supermileage/CAN-Accessories-2026/New CAN Accessories board/3D models/AT06-2S-SR01BLK.STEP

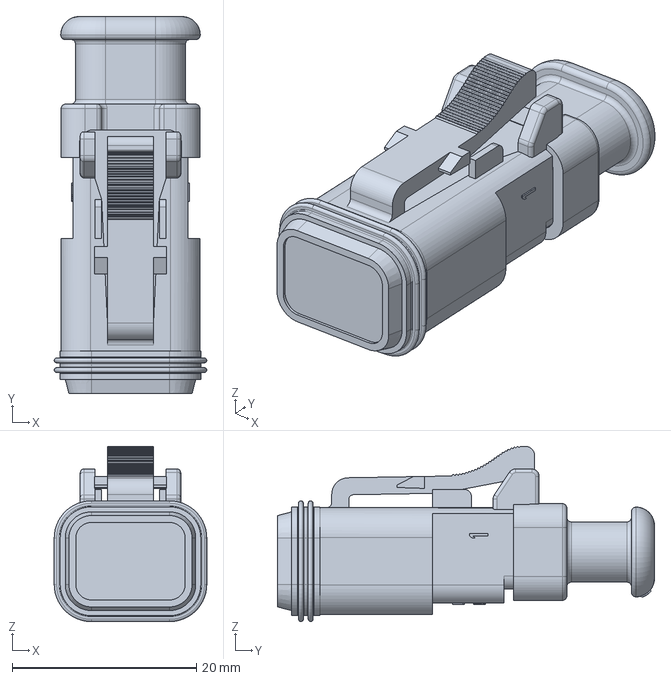
[picture p1: CAD file, 2025-10-22]
New CAN Accessories board/3D models/AT06-2S-SR01BLK.STEP
16.6 x 40.9 x 19.0 mm
