supermileage/CAN-Accessories-2026/New CAN Accessories board/topstencil.SLDPRT

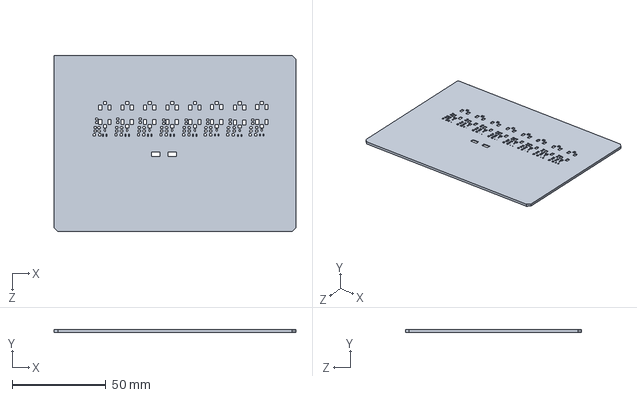
[picture p2: CAD file, 2025-10-27]
New CAN Accessories board/topstencil.SLDPRT
129.0 x 1.50 x 94.0 mm
