supermileage/CAN-Accessories-2026/PCB enclosure/box-can-accessories.SLDPRT

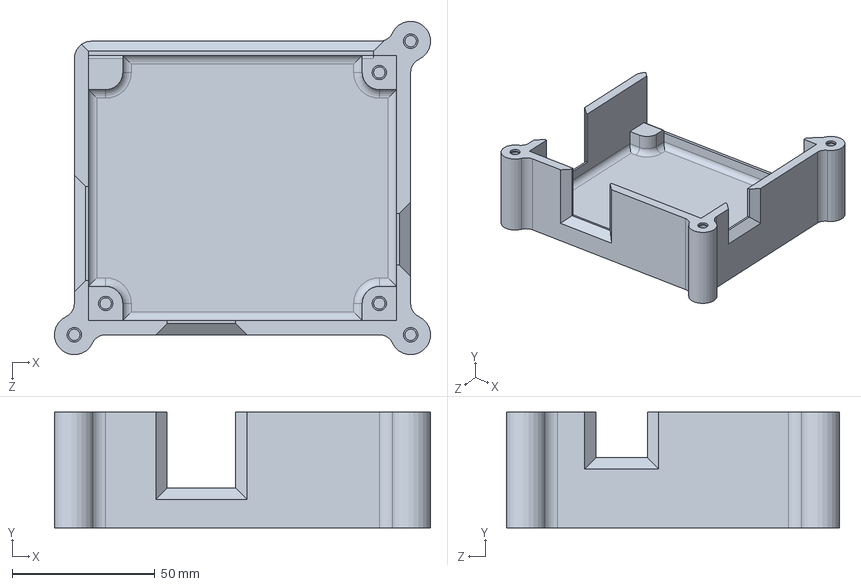
[picture p3: CAD file, 2025-10-27]
PCB enclosure/box-can-accessories.SLDPRT
131.9 x 40.6 x 116.9 mm
