supermileage/CAN-Accessories-2026/New CAN Accessories board/3D models/HHXC350ARA271MJA0G.stp

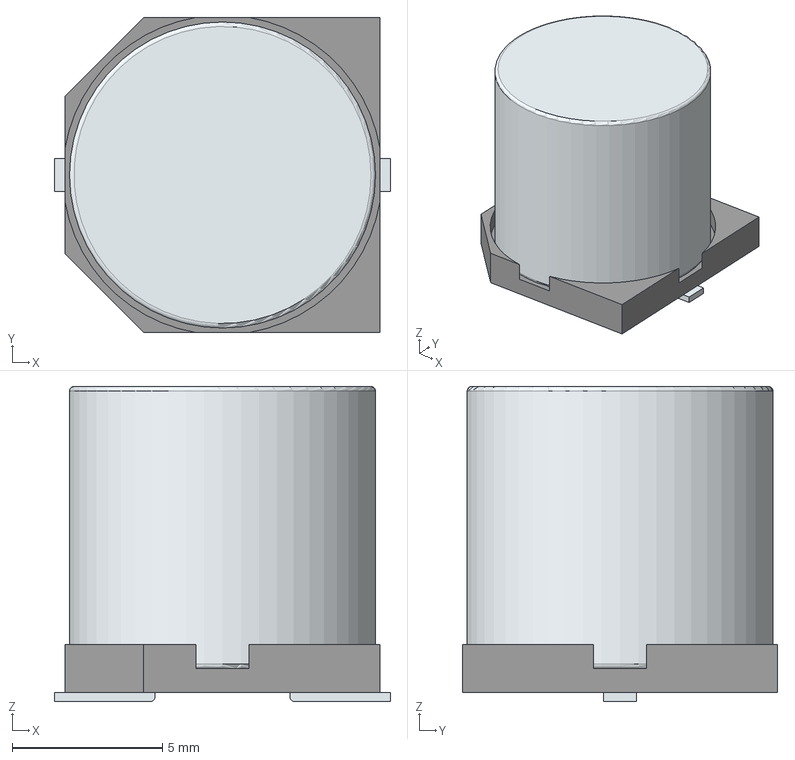
[picture p4: CAD file, 2025-10-19]
New CAN Accessories board/3D models/HHXC350ARA271MJA0G.stp
11.2 x 10.5 x 10.5 mm
Base
Pin1Fillet
Pin2Fillet
