supermileage/CAN-Accessories-2026/New CAN Accessories board/New CAN Accessories board-PasteBottom.dxf

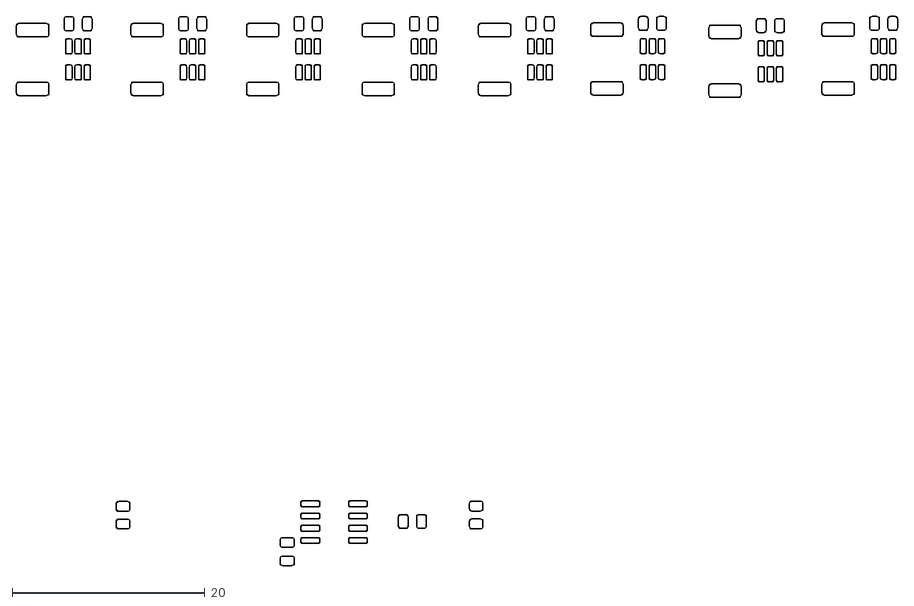
[picture p5: CAD file, 2025-10-27]
New CAN Accessories board/New CAN Accessories board-PasteBottom.dxf
91.5 x 57.0
