supermileage/CAN-Accessories-2026/New CAN Accessories board/New CAN Accessories board-PasteTop.dxf

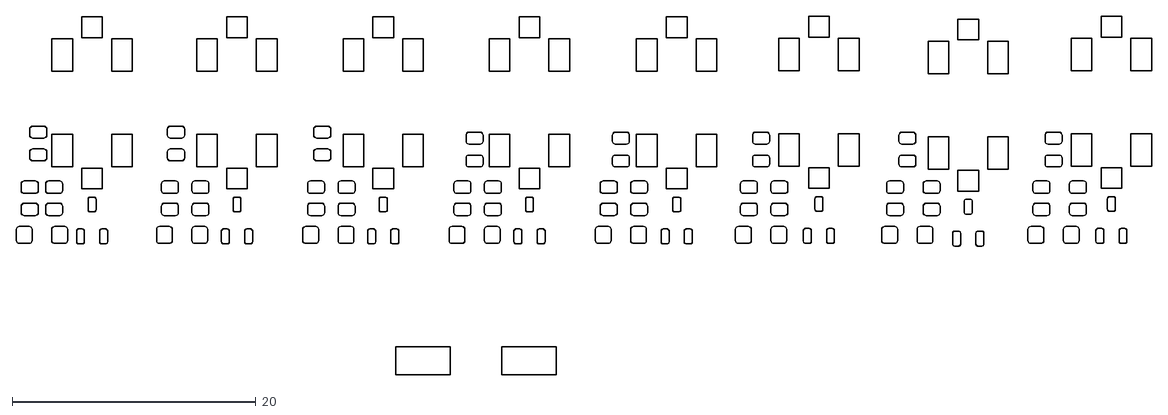
[picture p6: CAD file, 2025-10-27]
New CAN Accessories board/New CAN Accessories board-PasteTop.dxf
93.1 x 29.4
