supermileage/CAN-Accessories-2026/New CAN Accessories board/New CAN Accessories board-EdgeCuts.dxf

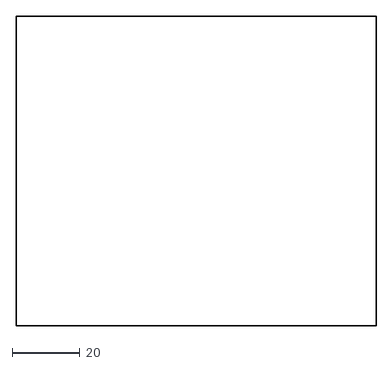
[picture p7: CAD file, 2025-10-27]
New CAN Accessories board/New CAN Accessories board-EdgeCuts.dxf
106.0 x 91.0
