supermileage/CAN-Accessories-2026/New CAN Accessories board/3D models/3586KTR.stp

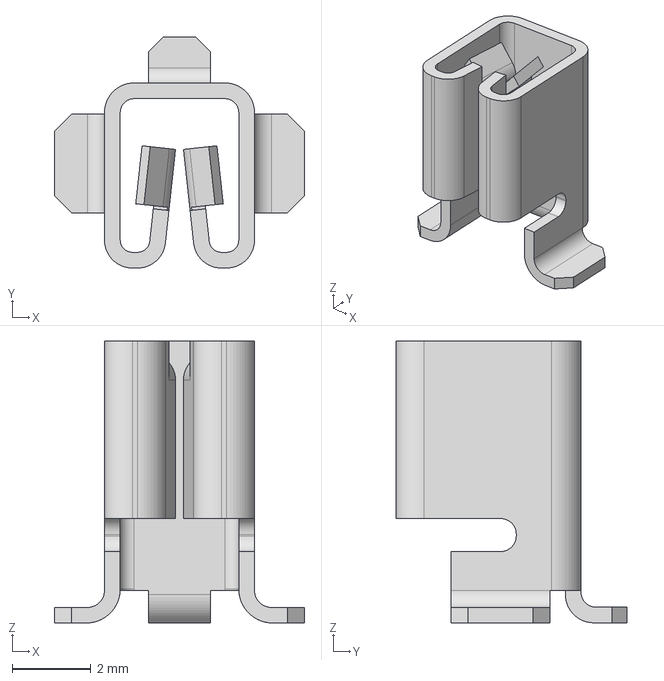
[picture p8: CAD file, 2025-10-18]
New CAN Accessories board/3D models/3586KTR.stp
6.35 x 5.87 x 7.16 mm
