supermileage/CAN-Accessories-2026/New CAN Accessories board/3D models/ATF13-2P-BM03.STEP

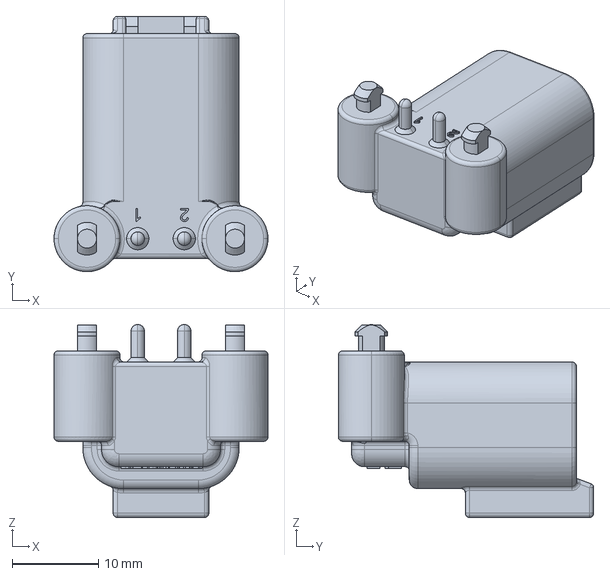
[picture p9: CAD file, 2025-10-18]
New CAN Accessories board/3D models/ATF13-2P-BM03.STEP
24.8 x 29.6 x 22.4 mm
