supermileage/CAN-Accessories-2026/New CAN Accessories board/3D models/PPPC151LFBN-RC.STEP

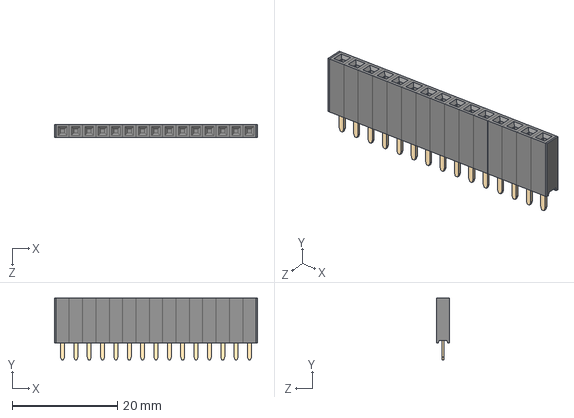
[picture p10: CAD file, 2025-10-18]
New CAN Accessories board/3D models/PPPC151LFBN-RC.STEP
38.6 x 11.7 x 2.54 mm
PPPC021LFBN-RC_C15
Pin - Gold x 15
