supermileage/CAN-Accessories-2026/New CAN Accessories board/3D models/039301040.stp

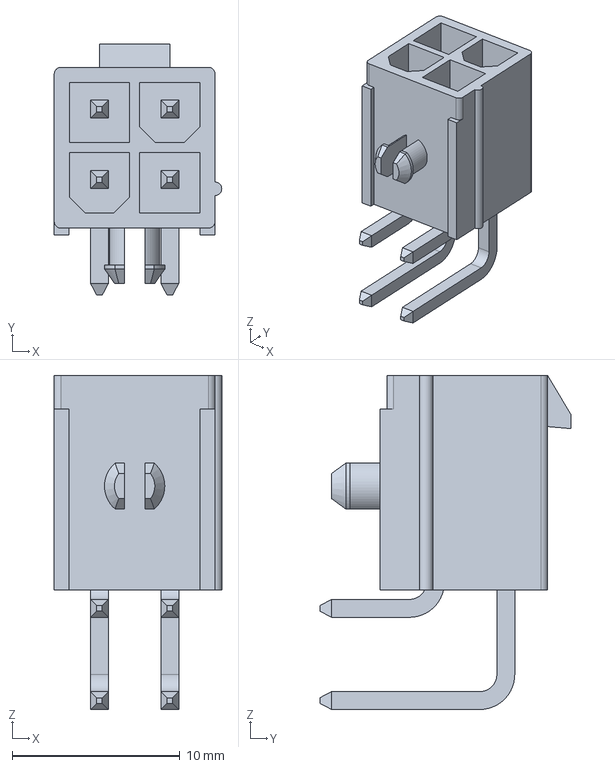
[picture p11: CAD file, 2025-10-18]
New CAN Accessories board/3D models/039301040.stp
10.0 x 15.0 x 19.9 mm
