supermileage/CAN-Accessories-2026/New CAN Accessories board/3D models/JS202011CQN.STEP

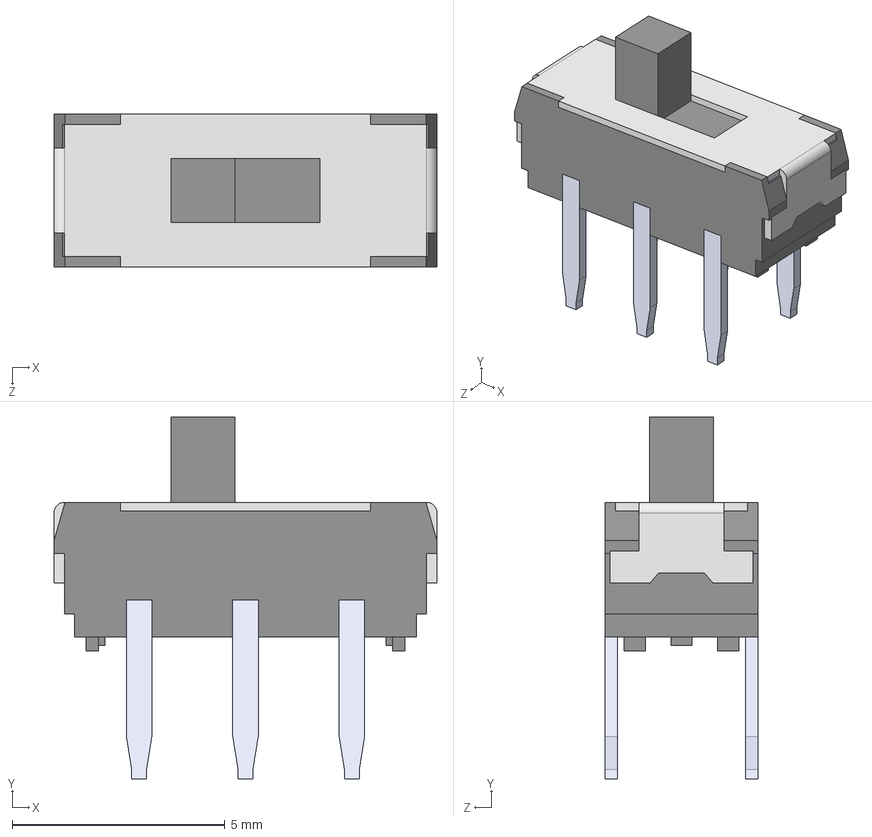
[picture p12: CAD file, 2025-10-18]
New CAN Accessories board/3D models/JS202011CQN.STEP
9.00 x 8.50 x 3.60 mm
