supermileage/CAN-Accessories-2026/New CAN Accessories board/3D models/039301060.stp

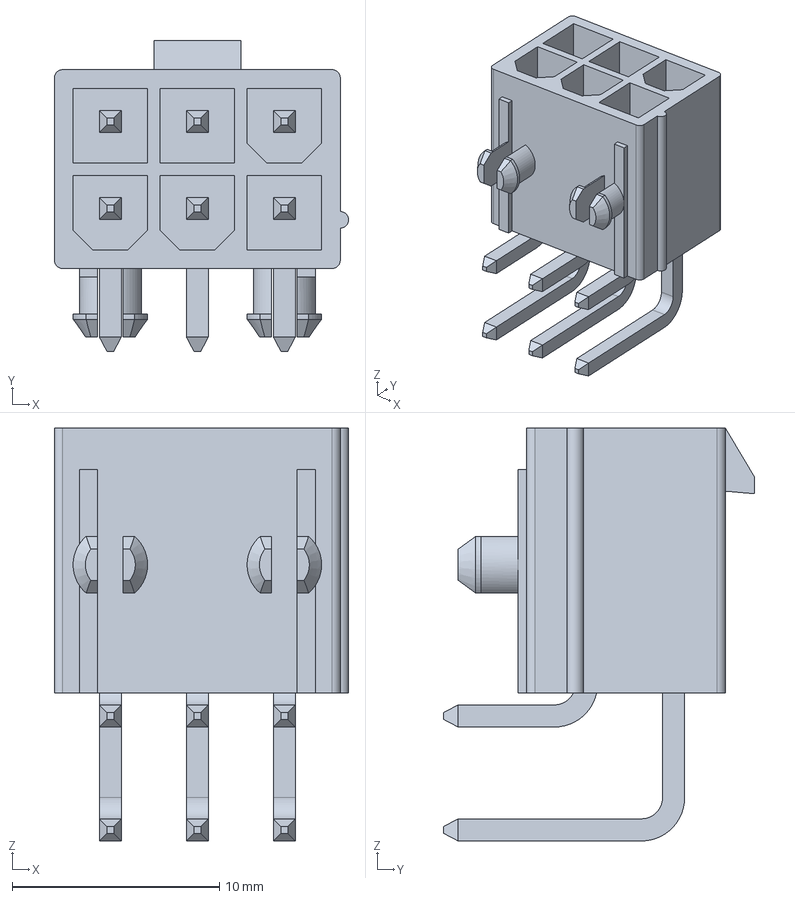
[picture p13: CAD file, 2025-10-18]
New CAN Accessories board/3D models/039301060.stp
14.2 x 15.0 x 19.9 mm
