supermileage/CAN-Accessories-2026/New CAN Accessories board/New CAN Accessories board.kicad_pcb

## KiCad design New CAN Accessories board/New CAN Accessories board.kicad_pcb (2025-10-27)

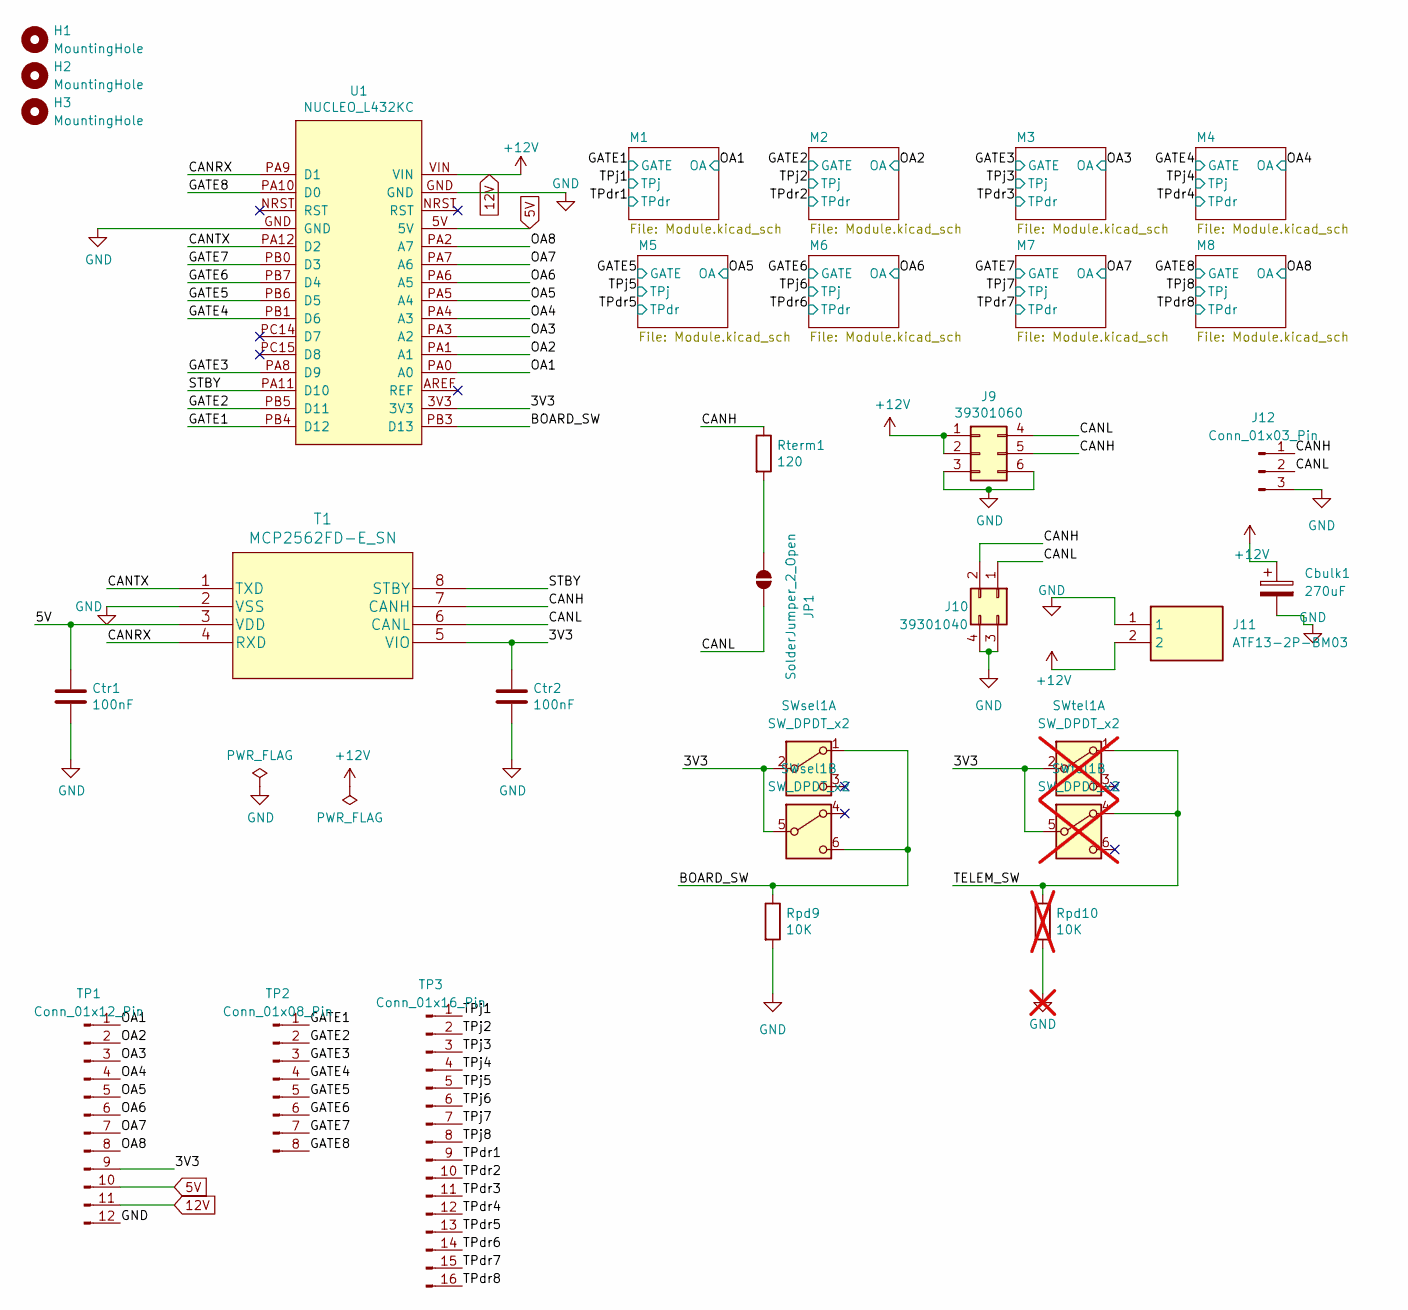
[picture p14: schematic New CAN Accessories board.kicad_sch]

Parts:
Cbulk1: 270uF; CAPAE1030X1050M
Ctr1, Ctr2: 100nF; C_0805_2012Metric
H1, H2, H3: MountingHole; MountingHole_3.2mm_M3_ISO14580
J9: 39301060; Molex_Mini-Fit_Jr_5569-06A2_2x03_P4.20mm_Horizontal
J10: 39301040; Molex_Mini-Fit_Jr_5569-04A2_2x02_P4.20mm_Horizontal
J11: ATF13-2P-BM03; ATF132PBM03; Mouser Part Number 654-ATF13-2P-BM03
J12: Conn_01x03_Pin; PinHeader_1x03_P2.54mm_Vertical
JP1: SolderJumper_2_Open; SolderJumper-2_P1.3mm_Open_Pad1.0x1.5mm
Rpd9: 10K; R_0805_2012Metric
Rpd10: 10K; R_0805_2012Metric; not fitted
Rterm1: 120; R_0805_2012Metric
SWsel1: SW_DPDT_x2; SWITCH_011CQN
SWtel1: SW_DPDT_x2; SWITCH_011CQN; not fitted
T1: MCP2562FD-E_SN; SOIC-8_3.9x4.9mm_P1.27mm
TP1: Conn_01x12_Pin; PinHeader_1x12_P2.54mm_Vertical
TP2: Conn_01x08_Pin; PinHeader_1x08_P2.54mm_Vertical
TP3: Conn_01x16_Pin; PinHeader_1x16_P2.54mm_Vertical
U1: NUCLEO_L432KC; MODULE_NUCLEO-L432KC

Connections:
5V: Ctr1.1, T1.3 (VDD), TP1.10, U1.5V; also elsewhere on the board
12V: Cbulk1.1, J9.1, J9.2, J11.2, TP1.11, U1.VIN; also elsewhere on the board
/3V3: Ctr2.1, SWsel1.2 (B), SWsel1.5 (B), SWtel1.2 (B), SWtel1.5 (B), T1.5 (VIO), TP1.9, U1.3V3
/BOARD_SW: Rpd9.1, SWsel1.1 (A), SWsel1.6 (C), U1.PB3 (D13)
/CANH: J9.5, J10.2, J12.1, Rterm1.1, T1.7 (CANH)
/CANL: J9.4, J10.1, J12.2, JP1.2 (B), T1.6 (CANL)
/CANRX: T1.4 (RXD), U1.PA9 (D1)
/CANTX: T1.1 (TXD), U1.PA12 (D2)
/GATE1: TP2.1, U1.PB4 (D12); also elsewhere on the board
/GATE2: TP2.2, U1.PB5 (D11); also elsewhere on the board
/GATE3: TP2.3, U1.PA8 (D9); also elsewhere on the board
/GATE4: TP2.4, U1.PB1 (D6); also elsewhere on the board
/GATE5: TP2.5, U1.PB6 (D5); also elsewhere on the board
/GATE6: TP2.6, U1.PB7 (D4); also elsewhere on the board
/GATE7: TP2.7, U1.PB0 (D3); also elsewhere on the board
/GATE8: TP2.8, U1.PA10 (D0); also elsewhere on the board
/OA1: TP1.1, U1.PA0 (A0); also elsewhere on the board
/OA2: TP1.2, U1.PA1 (A1); also elsewhere on the board
/OA3: TP1.3, U1.PA3 (A2); also elsewhere on the board
/OA4: TP1.4, U1.PA4 (A3); also elsewhere on the board
/OA5: TP1.5, U1.PA5 (A4); also elsewhere on the board
/OA6: TP1.6, U1.PA6 (A5); also elsewhere on the board
/OA7: TP1.7, U1.PA7 (A6); also elsewhere on the board
/OA8: TP1.8, U1.PA2 (A7); also elsewhere on the board
/STBY: T1.8 (STBY), U1.PA11 (D10)
/TPdr1: TP3.9; also elsewhere on the board
/TPdr2: TP3.10; also elsewhere on the board
/TPdr3: TP3.11; also elsewhere on the board
/TPdr4: TP3.12; also elsewhere on the board
/TPdr5: TP3.13; also elsewhere on the board
/TPdr6: TP3.14; also elsewhere on the board
/TPdr7: TP3.15; also elsewhere on the board
/TPdr8: TP3.16; also elsewhere on the board
/TPj1: TP3.1; also elsewhere on the board
/TPj2: TP3.2; also elsewhere on the board
/TPj3: TP3.3; also elsewhere on the board
/TPj4: TP3.4; also elsewhere on the board
/TPj5: TP3.5; also elsewhere on the board
/TPj6: TP3.6; also elsewhere on the board
/TPj7: TP3.7; also elsewhere on the board
/TPj8: TP3.8; also elsewhere on the board
GND: Cbulk1.2, Ctr1.2, Ctr2.2, J9.3, J9.6, J10.3, J10.4, J11.1, J12.3, Rpd9.2, Rpd10.2, T1.2 (VSS), TP1.12, U1.GND; also elsewhere on the board
unnamed: JP1.1 (A), Rterm1.2
unnamed: Rpd10.1, SWtel1.1 (A), SWtel1.4 (A)

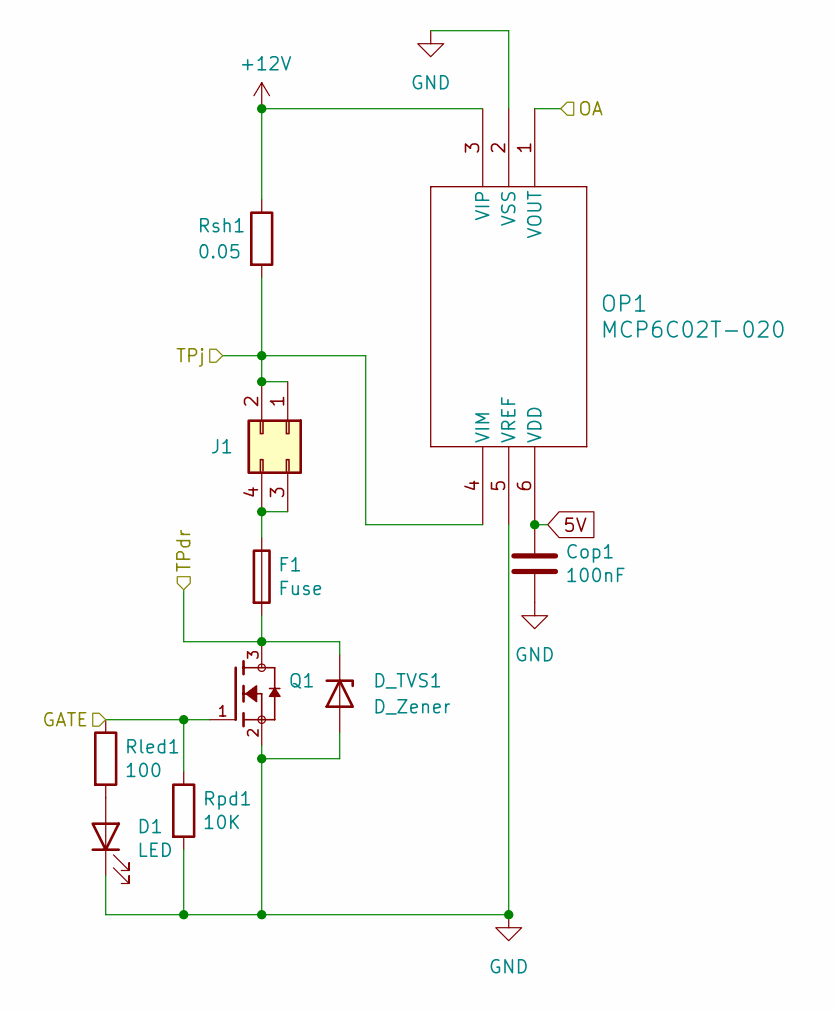
[picture p15: schematic Module.kicad_sch]

Parts:
Cop1: 100nF; C_0805_2012Metric
D1: LED; LED_0805_2012Metric
D_TVS1: D_Zener; D_SMF
F1: Fuse; 3586KTR
J1: 39301040; Molex_Mini-Fit_Jr_5569-04A2_2x02_P4.20mm_Horizontal
OP1: MCP6C02T-020; SOT-23-6_Handsoldering
Q1: IRLML6344TRPBF; TSOT-23; PARTREV December 19, 2014
Rled1: 100; R_0805_2012Metric
Rpd1: 10K; R_0805_2012Metric
Rsh1: 0.05; R_2512_6332Metric_Pad1.40x3.35mm_HandSolder

Connections:
5V: Cop1.1, OP1.6 (VDD); also elsewhere on the board
12V: OP1.3 (VIP), Rsh1.1; also elsewhere on the board
/GATE1: Q1.1, Rled1.1, Rpd1.1; also elsewhere on the board
/OA1: OP1.1 (VOUT); also elsewhere on the board
/TPdr1: D_TVS1.1 (K), F1.2, Q1.3; also elsewhere on the board
/TPj1: J1.1, J1.2, OP1.4 (VIM), Rsh1.2; also elsewhere on the board
GND: Cop1.2, D1.1 (K), D_TVS1.2 (A), OP1.2 (VSS), OP1.5 (VREF), Q1.2, Rpd1.2; also elsewhere on the board
unnamed: D1.2 (A), Rled1.2
unnamed: F1.1, J1.3, J1.4

Parts of its further copies:
Cop2, Cop3, Cop4, Cop5, Cop6, Cop7, Cop8: 100nF; C_0805_2012Metric
D2, D3, D4, D5, D6, D7, D8: LED; LED_0805_2012Metric
D_TVS2, D_TVS3, D_TVS4, D_TVS5, D_TVS6, D_TVS7, D_TVS8: D_Zener; D_SMF
F2, F3, F4, F5, F6, F7, F8: Fuse; 3586KTR
J2, J3, J4, J5, J6, J7, J8: 39301040; Molex_Mini-Fit_Jr_5569-04A2_2x02_P4.20mm_Horizontal
OP2, OP3, OP4, OP5, OP6, OP7, OP8: MCP6C02T-020; SOT-23-6_Handsoldering
Q2, Q3, Q4, Q5, Q6, Q7, Q8: IRLML6344TRPBF; TSOT-23; PARTREV December 19, 2014
Rled2, Rled3, Rled4, Rled5, Rled6, Rled7, Rled8: 100; R_0805_2012Metric
Rpd2, Rpd3, Rpd4, Rpd5, Rpd6, Rpd7, Rpd8: 10K; R_0805_2012Metric
Rsh2, Rsh3, Rsh4, Rsh5, Rsh6, Rsh7, Rsh8: 0.05; R_2512_6332Metric_Pad1.40x3.35mm_HandSolder

Connections of its further copies:
5V: Cop2.1, Cop3.1, Cop4.1, Cop5.1, Cop6.1, Cop7.1, Cop8.1, OP2.6 (VDD), OP3.6 (VDD), OP4.6 (VDD), OP5.6 (VDD), OP6.6 (VDD), OP7.6 (VDD), OP8.6 (VDD); also elsewhere on the board
12V: OP2.3 (VIP), OP3.3 (VIP), OP4.3 (VIP), OP5.3 (VIP), OP6.3 (VIP), OP7.3 (VIP), OP8.3 (VIP), Rsh2.1, Rsh3.1, Rsh4.1, Rsh5.1, Rsh6.1, Rsh7.1, Rsh8.1; also elsewhere on the board
/GATE2: Q2.1, Rled2.1, Rpd2.1; also elsewhere on the board
/GATE3: Q3.1, Rled3.1, Rpd3.1; also elsewhere on the board
/GATE4: Q4.1, Rled4.1, Rpd4.1; also elsewhere on the board
/GATE5: Q5.1, Rled5.1, Rpd5.1; also elsewhere on the board
/GATE6: Q6.1, Rled6.1, Rpd6.1; also elsewhere on the board
/GATE7: Q7.1, Rled7.1, Rpd7.1; also elsewhere on the board
/GATE8: Q8.1, Rled8.1, Rpd8.1; also elsewhere on the board
/OA2: OP2.1 (VOUT); also elsewhere on the board
/OA3: OP3.1 (VOUT); also elsewhere on the board
/OA4: OP4.1 (VOUT); also elsewhere on the board
/OA5: OP5.1 (VOUT); also elsewhere on the board
/OA6: OP6.1 (VOUT); also elsewhere on the board
/OA7: OP7.1 (VOUT); also elsewhere on the board
/OA8: OP8.1 (VOUT); also elsewhere on the board
/TPdr2: D_TVS2.1 (K), F2.2, Q2.3; also elsewhere on the board
/TPdr3: D_TVS3.1 (K), F3.2, Q3.3; also elsewhere on the board
/TPdr4: D_TVS4.1 (K), F4.2, Q4.3; also elsewhere on the board
/TPdr5: D_TVS5.1 (K), F5.2, Q5.3; also elsewhere on the board
/TPdr6: D_TVS6.1 (K), F6.2, Q6.3; also elsewhere on the board
/TPdr7: D_TVS7.1 (K), F7.2, Q7.3; also elsewhere on the board
/TPdr8: D_TVS8.1 (K), F8.2, Q8.3; also elsewhere on the board
/TPj2: J2.1, J2.2, OP2.4 (VIM), Rsh2.2; also elsewhere on the board
/TPj3: J3.1, J3.2, OP3.4 (VIM), Rsh3.2; also elsewhere on the board
/TPj4: J4.1, J4.2, OP4.4 (VIM), Rsh4.2; also elsewhere on the board
/TPj5: J5.1, J5.2, OP5.4 (VIM), Rsh5.2; also elsewhere on the board
/TPj6: J6.1, J6.2, OP6.4 (VIM), Rsh6.2; also elsewhere on the board
/TPj7: J7.1, J7.2, OP7.4 (VIM), Rsh7.2; also elsewhere on the board
/TPj8: J8.1, J8.2, OP8.4 (VIM), Rsh8.2; also elsewhere on the board
GND: Cop2.2, Cop3.2, Cop4.2, Cop5.2, Cop6.2, Cop7.2, Cop8.2, D2.1 (K), D3.1 (K), D4.1 (K), D5.1 (K), D6.1 (K), D7.1 (K), D8.1 (K), D_TVS2.2 (A), D_TVS3.2 (A), D_TVS4.2 (A), D_TVS5.2 (A), D_TVS6.2 (A), D_TVS7.2 (A), D_TVS8.2 (A), OP2.2 (VSS), OP2.5 (VREF), OP3.2 (VSS), OP3.5 (VREF), OP4.2 (VSS), OP4.5 (VREF), OP5.2 (VSS), OP5.5 (VREF), OP6.2 (VSS), OP6.5 (VREF), OP7.2 (VSS), OP7.5 (VREF), OP8.2 (VSS), OP8.5 (VREF), Q2.2, Q3.2, Q4.2, Q5.2, Q6.2, Q7.2, Q8.2, Rpd2.2, Rpd3.2, Rpd4.2, Rpd5.2, Rpd6.2, Rpd7.2, Rpd8.2; also elsewhere on the board
unnamed: D2.2 (A), Rled2.2
unnamed: D3.2 (A), Rled3.2
unnamed: D4.2 (A), Rled4.2
unnamed: D5.2 (A), Rled5.2
unnamed: D6.2 (A), Rled6.2
unnamed: D7.2 (A), Rled7.2
unnamed: D8.2 (A), Rled8.2
unnamed: F2.1, J2.3, J2.4
unnamed: F3.1, J3.3, J3.4
unnamed: F4.1, J4.3, J4.4
unnamed: F5.1, J5.3, J5.4
unnamed: F6.1, J6.3, J6.4
unnamed: F7.1, J7.3, J7.4
unnamed: F8.1, J8.3, J8.4

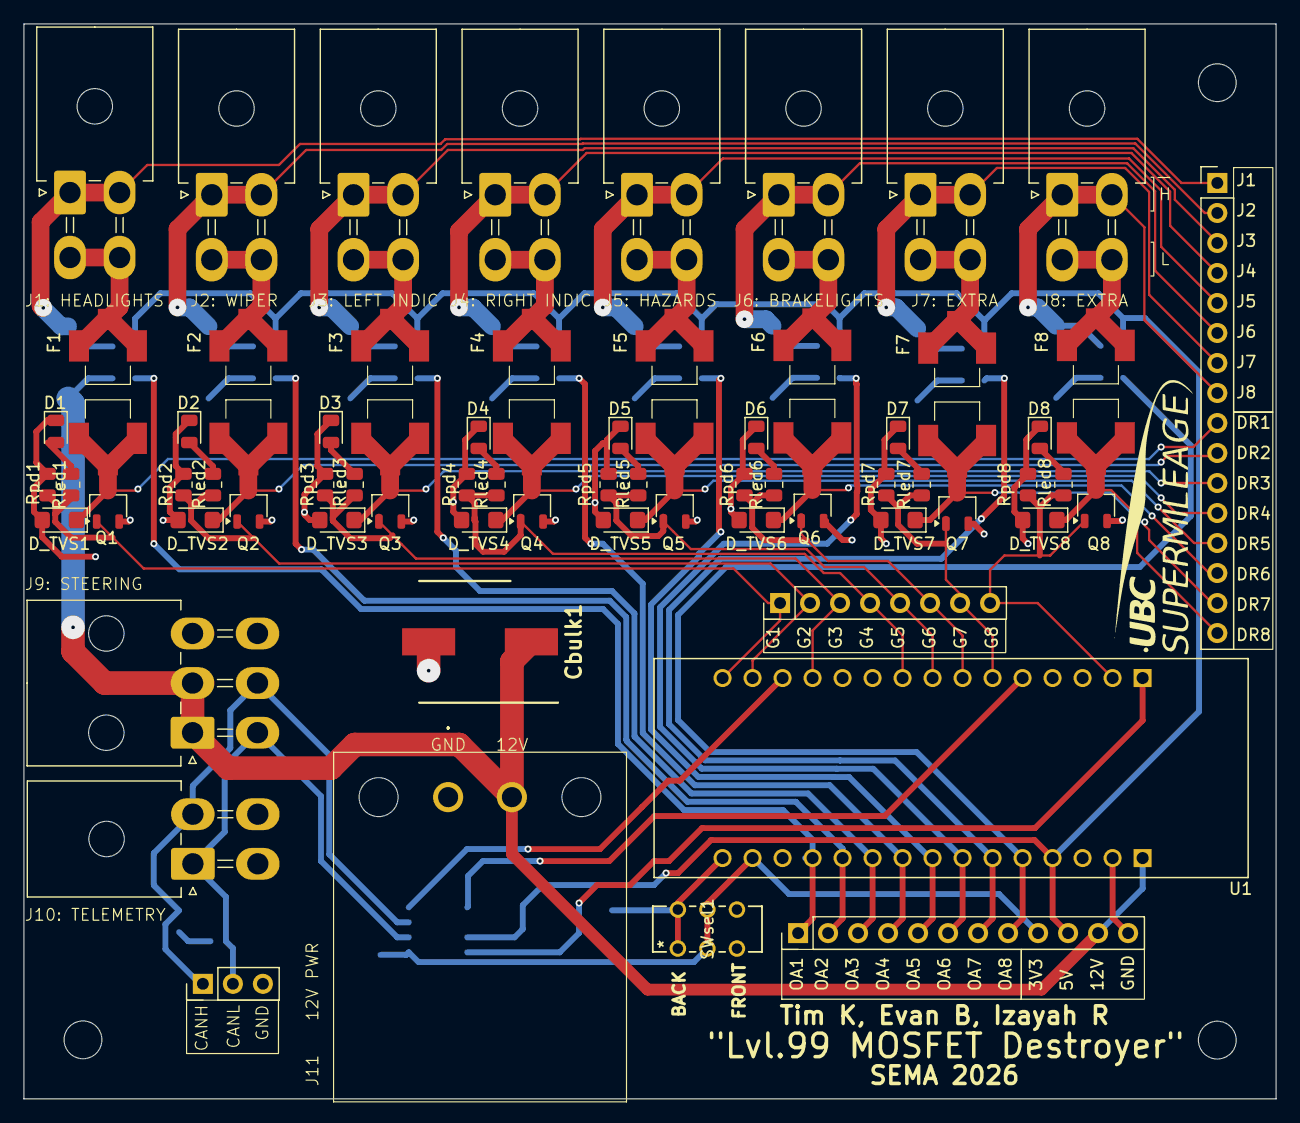
[picture p16: board New CAN Accessories board.kicad_pcb from above]

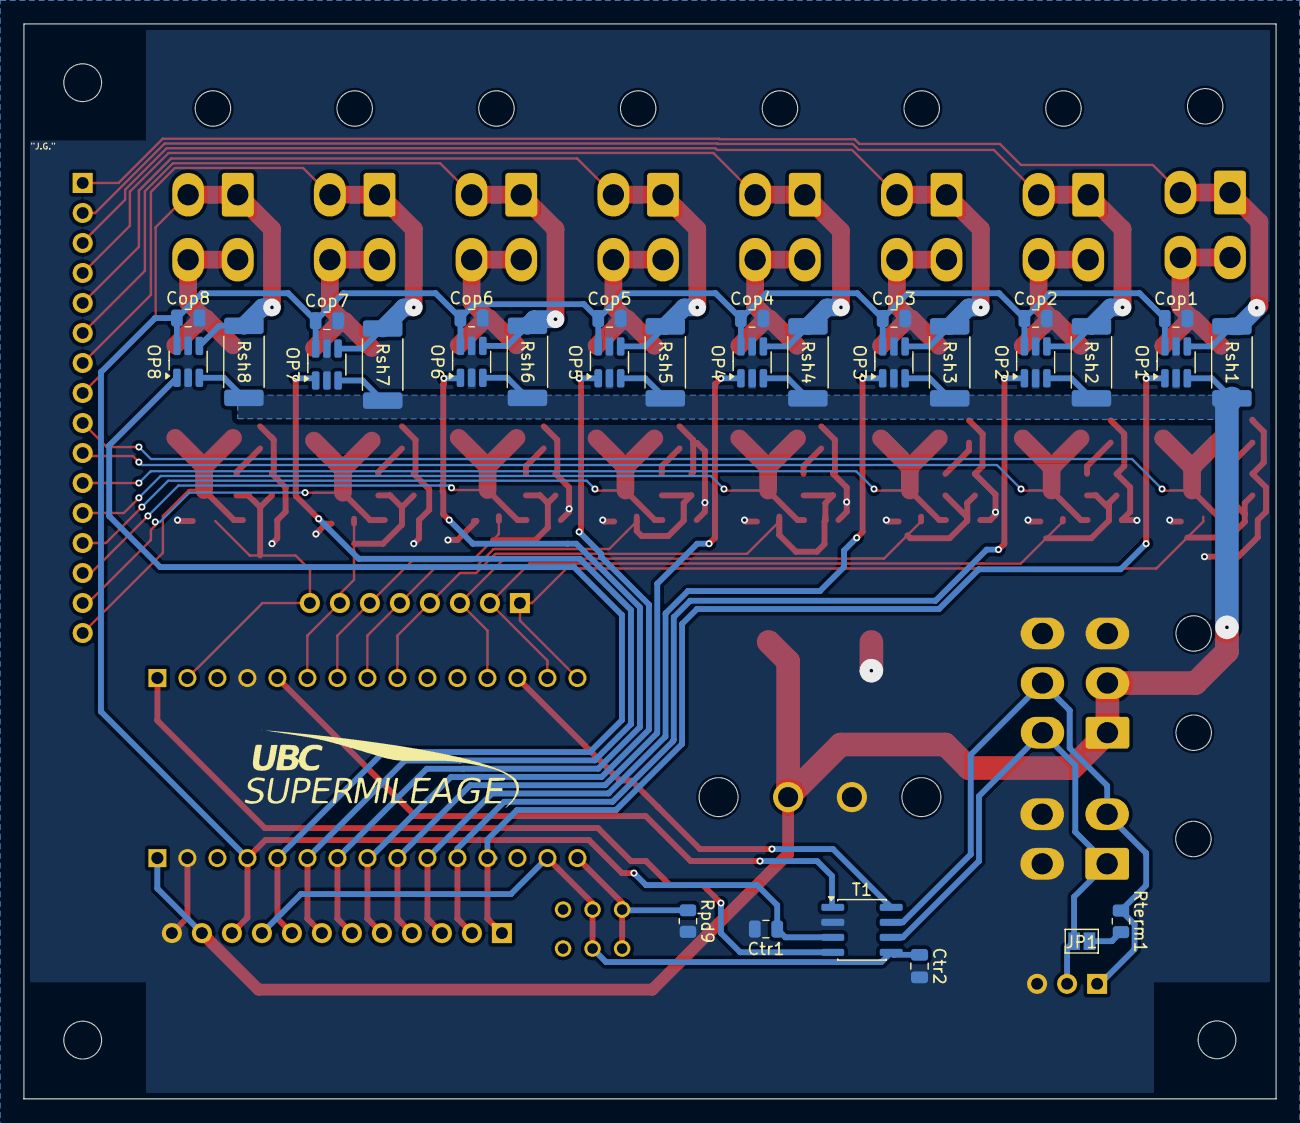
[picture p17: board New CAN Accessories board.kicad_pcb from below]

Board: 2 copper layers, 106.0 x 91.0 mm, 99 parts (30 on the bottom side), 59 nets.
