supermileage/CAN-Accessories-2026/(commit log)

2025-09-27 created new kicad project file
    [New CAN Accessories board.kicad_pcb, New CAN Accessories board.kicad_sch]
2025-09-30 updated schematic to add high side sensing, haven't speced specific components yet
    [New CAN Accessories board.kicad_sch]
2025-10-05 updated kicad schematic to include new op amps and update layout
    [New CAN Accessories board.kicad_sch]
2025-10-05 updated schematic again, all parts match bom, for final review
    [New CAN Accessories board.kicad_sch]
2025-10-09 deleted 3 outside connectors
    [New CAN Accessories board.kicad_sch]
2025-10-09 Changed switch symbols
    [New CAN Accessories board.kicad_sch]
2025-10-11 Footprints updated
    [New CAN Accessories board.kicad_sch]
2025-10-12 Added decoupling caps on opamps, improved part designator labelling and naming
    [New CAN Accessories board.kicad_sch]
2025-10-16 split J10 into 2pin 12V connector and 4pin can connector
    [New CAN Accessories board.kicad_sch]
2025-10-17 preliminary layout complete
    [New CAN Accessories board.kicad_pcb, New CAN Accessories board.kicad_sch]
2025-10-18 added test points in schematic
    [New CAN Accessories board.kicad_pcb, New CAN Accessories board.kicad_sch]
2025-10-18 added 3d models
    [039301040.stp, 039301060.stp, 3586KTR.stp, ATF13-2P-BM03.STEP, JS202011CQN.STEP, Module.kicad_sch, PPPC151LFBN-RC.STEP]
2025-10-18 post design review
    [Module.kicad_sch, New CAN Accessories board.kicad_pcb, New CAN Accessories board.kicad_sch]
2025-10-18 Added test points 1x12 pin and 1x8 pin
    [Module.kicad_sch, New CAN Accessories board.kicad_pcb, New CAN Accessories board.kicad_sch]
2025-10-19 added bulk cap
    [HHXC350ARA271MJA0G.stp, New CAN Accessories board.kicad_pcb, New CAN Accessories board.kicad_sch]
2025-10-19 Added two 1x4 pin headers for J1-J8 - also fixed CAN module
    [Module.kicad_sch, New CAN Accessories board.kicad_pcb, New CAN Accessories board.kicad_sch]
2025-10-20 few labelling changes
    [New CAN Accessories board.kicad_pcb]
2025-10-20 added labellling changes noted in design review
    [New CAN Accessories board.kicad_pcb, New CAN Accessories board.kicad_sch]
2025-10-20 very minor positioning and labelling changes
    [New CAN Accessories board.kicad_pcb]
2025-10-20 resolve merge conflict
    [New CAN Accessories board.kicad_pcb]
2025-10-22 added supermileage logo and names
    [AT06-2S-SR01BLK.STEP, New CAN Accessories board.kicad_pcb]
2025-10-22 added TVS diode to schematic
    [Module.kicad_sch, New CAN Accessories board.kicad_pcb]
2025-10-22 named tvs diode correctly
    [Module.kicad_sch]
2025-10-23 started making drain test point changes
    [Module.kicad_sch, New CAN Accessories board.kicad_pcb, New CAN Accessories board.kicad_sch]
2025-10-23 1x16 header test points
    [Module.kicad_sch, New CAN Accessories board.kicad_pcb, New CAN Accessories board.kicad_sch]
2025-10-24 TVS Diode added
    [New CAN Accessories board.kicad_pcb]
2025-10-24 Silk screen fixes
    [New CAN Accessories board.kicad_pcb]
2025-10-24 Removed redundant trace
    [New CAN Accessories board.kicad_pcb]
2025-10-24 Fixed rled 6 silkscreen
    [New CAN Accessories board.kicad_pcb]
2025-10-24 updated diode placement
    [New CAN Accessories board.kicad_pcb]
2025-10-24 finalized PCB design
    [New CAN Accessories board.kicad_pcb, New CAN Accessories board.kicad_sch]
2025-10-24 final final design (changed a couple traces)
    [New CAN Accessories board.kicad_pcb]
2025-10-27 PCB enclosure v1, and PlatformIO project created
    [New CAN Accessories board-EdgeCuts.dxf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]
2025-11-22 Case 0 Implementation
2025-11-29 combining current sensing and all cases
2025-11-29 fixed cpp dupe error
    [accessory.cpp]
2025-11-30 fixed acc.cpp merge conflict
    [accessory.cpp]
2025-12-05 Cleaned up code and fixed front vs. back acc implementation
    [accessory.h, main.cpp]
2026-01-06 telemetry added, fixed blinking led3
    [accessory.cpp, accessory.h, main.cpp]
2026-02-01 switched horn gate from gate 5 to gate 7, commented out all telemetry code
